HDwayne/SolarArduino/img/bois.JPG

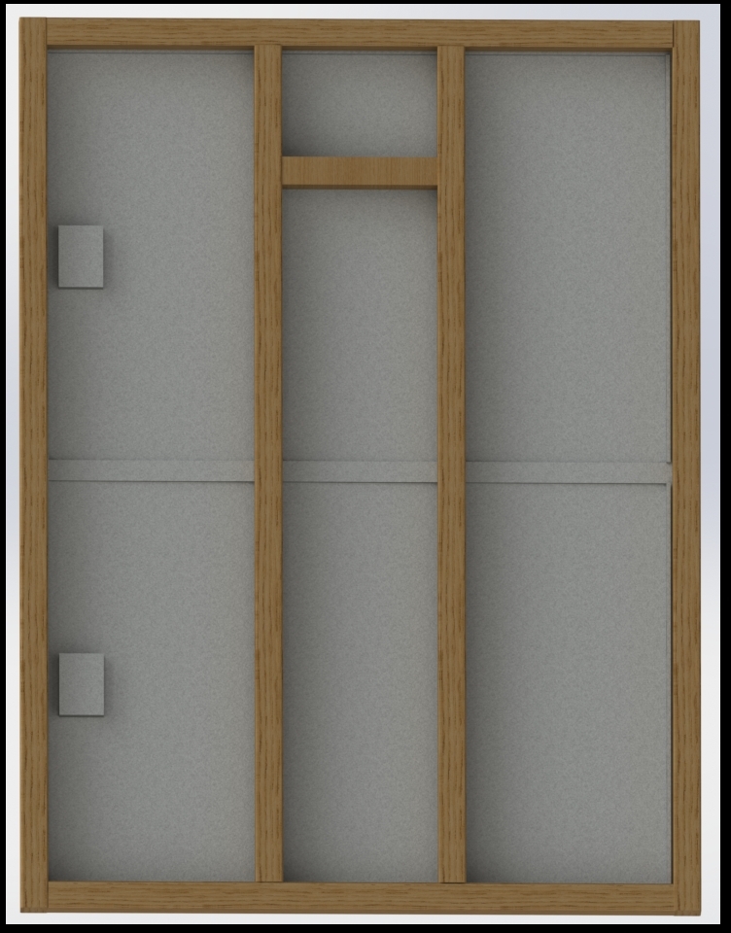
img/bois.JPG
