HDwayne/SolarArduino/src/modules/OTAModule.cpp

#include "OTAModule.h"

#include <WiFi.h>
#include <ArduinoOTA.h>
#include "utils/Logger.h"
#include "modules/ConfigModule.h"

extern ConfigModule configModule;
extern Logger Log;

// ----------------- OTA Module Constructor -----------------

OTAModule::OTAModule() {}

// ----------------- OTA control functions -----------------

void OTAModule::init()
{
  device_name = configModule.getDeviceName();
  WiFi.macAddress(macAddr);
  createDiscoveryUniqueID();

  ArduinoOTA.setHostname(devUniqueID);

  ArduinoOTA
      .onStart([]()
               {
        String type;
        if (ArduinoOTA.getCommand() == U_FLASH)
          type = "sketch";
        else // U_SPIFFS
          type = "filesystem";
        Log.println("Start updating " + type); })
      .onEnd([]()
             { Log.println("\nEnd"); })
      .onProgress([](unsigned int progress, unsigned int total)
                  { Log.printf("Progress: %u%%\r", (progress / (total / 100))); })
      .onError([](ota_error_t error)
               {
        Log.printf("Error[%u]: ", error);
        if (error == OTA_AUTH_ERROR)
          Log.println("Auth Failed");
        else if (error == OTA_BEGIN_ERROR)
          Log.println("Begin Failed");
        else if (error == OTA_CONNECT_ERROR)
          Log.println("Connect Failed");
        else if (error == OTA_RECEIVE_ERROR)
          Log.println("Receive Failed");
        else if (error == OTA_END_ERROR)
          Log.println("End Failed"); });

  ArduinoOTA.begin();
}

void OTAModule::loop()
{
  ArduinoOTA.handle();
}

void OTAModule::createDiscoveryUniqueID()
{
  strcpy(devUniqueID, device_name);
  int preSizeBytes = strlen(device_name);
  int j = 0;
  for (int i = 2; i >= 0; i--)
  {
    sprintf(&devUniqueID[preSizeBytes + j], "%02X", macAddr[i]);
    j += 2;
  }
  Log.println(devUniqueID);
}
