HDwayne/SolarArduino/(commit log)

2024-08-18 chore: Update azimuth calibration procedure
2024-08-18 Update azimuth calibration procedure
2024-08-18 Update platformio.ini for uno board
2024-08-18 chore: Update platformio.ini for uno board and fix serial
    [main.cpp]
2024-08-24 fix: horizontal safety position only when azimuth outside tracking range
    [main.cpp]
2024-08-31 chore: Update button variable name and DebunceTime
2024-08-31 chore: change Calibrate azimuth and elevation order
2024-08-31 test: set azimuth and elevation thresholds for motor adjustment to 0
2024-08-31 fixbug: serial print
2024-09-01 feat: actuator full travel time can be forced
2024-09-01 fix: Update actuatorFullTravelTime calculation type
2024-09-07 fixbug: rename time to avoid conflict
    [main.cpp]
2024-09-07 Refactor pin configuration for different boards
2024-09-21 Fixbug: UTC / Local misuse
    [main.cpp]
2024-09-21 fix AnemometerMode function in header
    [main.h]
2024-09-21 Refactor joystick controller initialization and pin configuration
2024-09-23 add CAD files
2024-10-04 Update README.md
    Update Amazon links : motor, switch.
2024-10-05 bug: error mode, fullRotationDuration unknow before calibration
    [AzimuthController.cpp, main.cpp]
2024-10-06 fix module init order + ip OTA
    [main.cpp]
2024-10-06 fix + Azimuthcontroller compatible configmodule
    [AnemometerModule.cpp, AzimuthController.cpp, AzimuthController.h, MQTTModule.cpp, OTAModule.cpp, main.cpp]
2024-10-12 feat: configuration reset functions for each onglet
    [ConfigModule.cpp, ConfigModule.h, WebServerModule.cpp, WebServerModule.h]
2024-10-12 Update current azimuth and elevation display in system overview and update readme
2024-11-22 fix: request ESP restart
    [WebServerModule.cpp, WebServerModule.h, main.cpp]
2024-11-22 fix summer/winter fr time + HA time format
    [MQTTModule.h, RTCModule.cpp]
2025-02-28 remove arduino + cleaning
